imgcre/f411_wlcsp/hw/sheets/mcu.sch

## KiCad design hw/sheets/mcu.sch (2020-05-10)

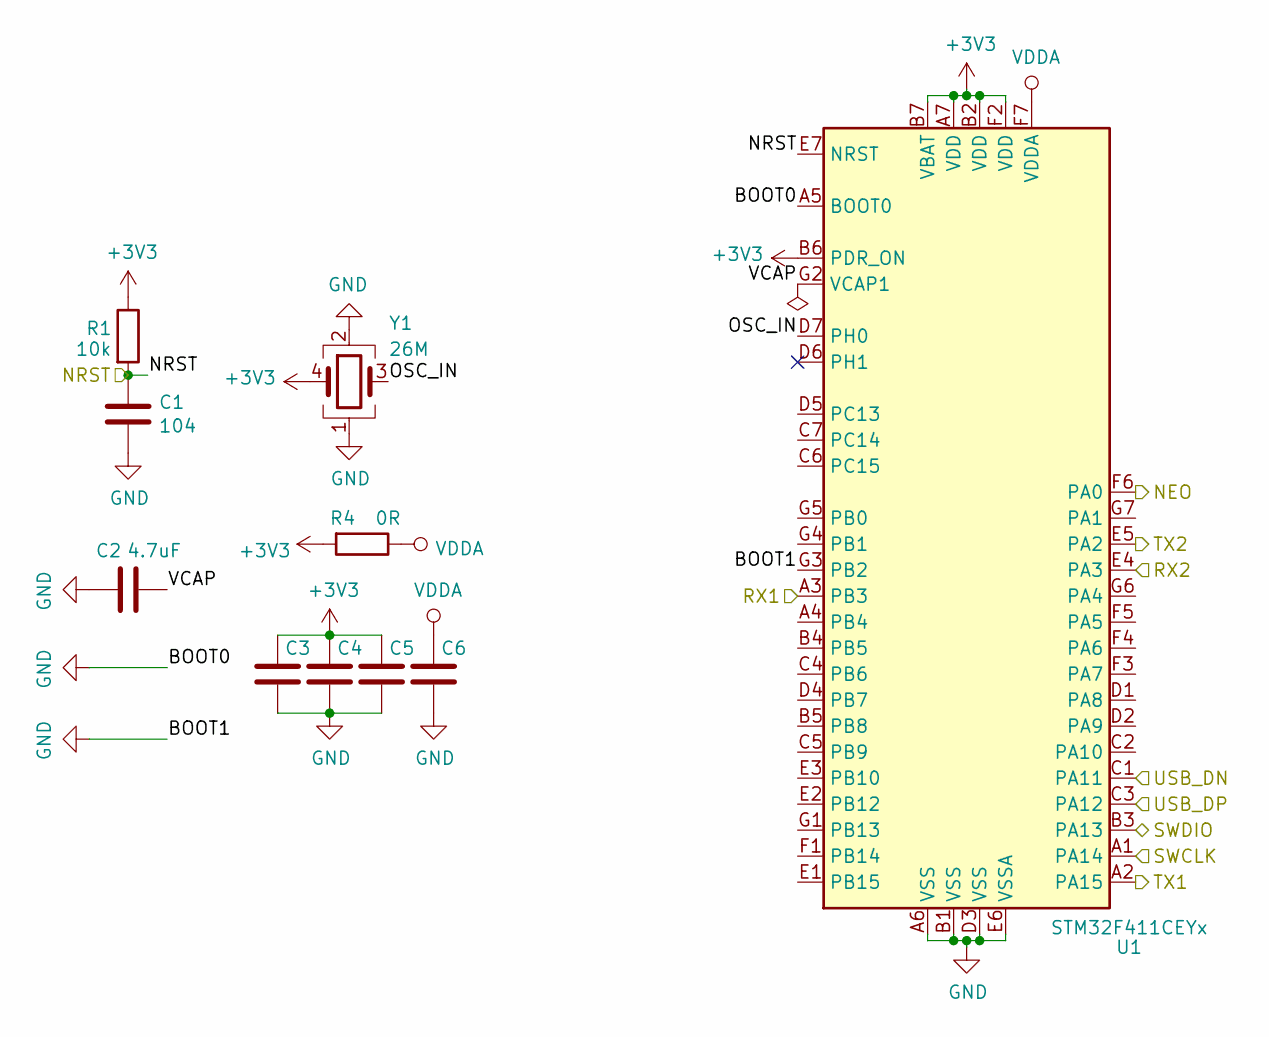
[picture p1: schematic mcu.sch]

Parts:
C1, C3, C4, C5, C6: 104; C_0201_0603Metric
C2: 4.7uF; C_0201_0603Metric
R1: 10k; R_0201_0603Metric
R4: 0R; R_0201_0603Metric
U1: STM32F411CEYx; ST_WLCSP-49_Die431
Y1: 26M; DSB211SDN

Connections:
+3V3: C3.1, C4.1, C5.1, R1.1, R4.2, U1.A7 (VDD), U1.B2 (VDD), U1.B6 (PDR_ON), U1.B7 (VBAT), U1.F2 (VDD), Y1.4 (IN)
GND: C1.2, C2.2, C3.2, C4.2, C5.2, C6.2, U1.A5 (BOOT0), U1.A6 (VSS), U1.B1 (VSS), U1.D3 (VSS), U1.E6 (VSSA), U1.G3 (PB2), Y1.1, Y1.2
NEO: U1.F6 (PA0)
NRST: C1.1, R1.2, U1.E7 (NRST)
OSC_IN: U1.D7 (PH0), Y1.3 (OUT)
RX1: U1.A3 (PB3)
RX2: U1.E4 (PA3)
SWCLK: U1.A1 (PA14)
SWDIO: U1.B3 (PA13)
TX1: U1.A2 (PA15)
TX2: U1.E5 (PA2)
USB_DN: U1.C1 (PA11)
USB_DP: U1.C3 (PA12)
VCAP: C2.1, U1.G2 (VCAP1)
VDDA: C6.1, R4.1, U1.F7 (VDDA)
